aftersignals/prototyping-smart-camera/static/bodegon02.png

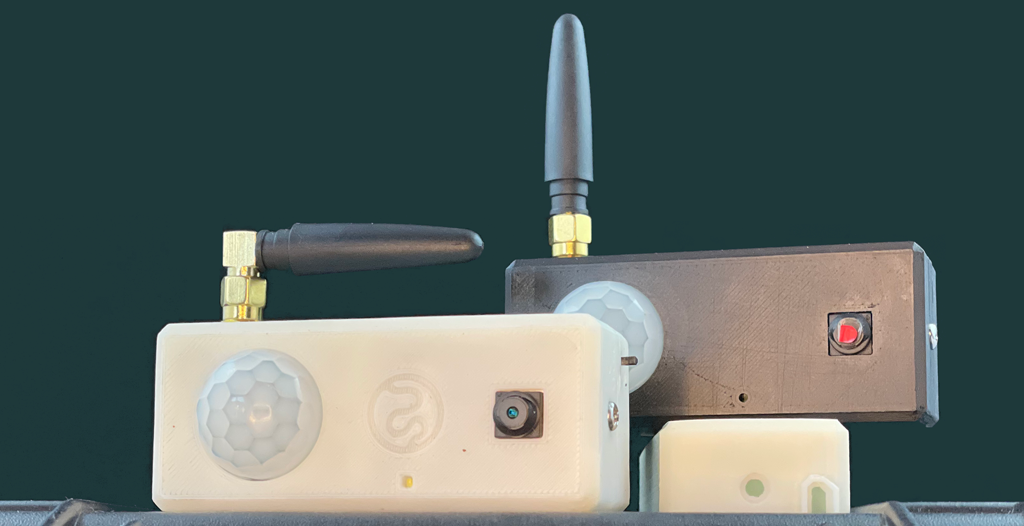
static/bodegon02.png
