aftersignals/prototyping-smart-camera/static/front-back01.png

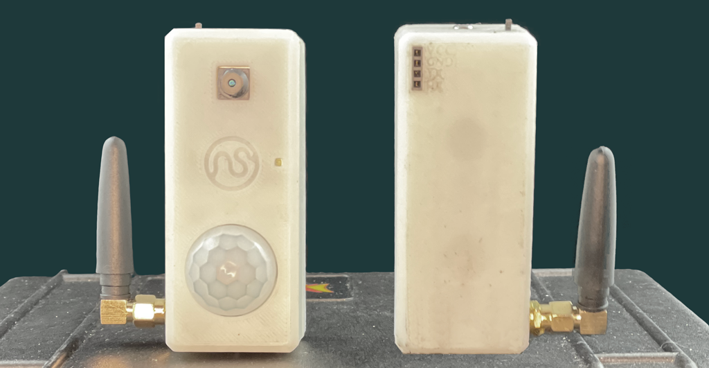
static/front-back01.png
